Vasilaki22/InkTime/(notices)

Notices in the files:
parts and their libraries:
InkTime_v5: COPYRIGHT: Copyright (C) 2024 Ultra Librarian. All rights reserved.
InkTime_v5: COPYRIGHT: Copyright (C) 2025 Ultra Librarian. All rights reserved.
